Daniel-Wait/EDesign/README.md

# EDesign314 Embedded Programming
## High Altitude Logger

3rd Year, 1st semester design project.

Read "20887507_EDesign314_Report.pdf" for further details.
