Daniel-Wait/EDesign/dbwait-edesign_2019_20887507-805f1194cbb3/20887507_ED314_HAB.ioc

Mcu.UserName=STM32F334R8Tx
PA0.Signal=ADC1_IN1
PA1.Signal=ADC1_IN2
PA10.Signal=GPIO_Output
PA11.Signal=GPIO_Output
PA12.Signal=GPIO_Output
PA8.Signal=GPIO_Output
PA9.Signal=GPIO_Output
PB1.Signal=GPIO_Output
PB8.Signal=GPIO_Output
PB9.Signal=GPIO_Output
PC4.Signal=USART1_TX
PC5.Signal=USART1_RX
